lraton/FlopperZiro/docs/README.md

# FlopperZiro

> ⚠️ **This is a fun, open-source DIY project** — not a professional device. It is a work in progress and the hardware, PCB, and software may change across updates.

FlopperZiro is a cheap, DIY, fully open-source multi-tool inspired by the Flipper Zero. It is built around the **STM32-L432KC** microcontroller and programmed via **Arduino IDE**. It packs RF, IR, RFID/NFC, BadUSB, and SD card support into a single hand-held device you can build yourself.

---

## Features at a glance

| Feature | Status |
|---|---|
| 🦆 BadUSB / RubberDucky | ✅ Working |
| 📡 RF 433 MHz — scan, save, replay | ✅ Working |
| 🔴 IR — scan, save, replay | ✅ Working |
| 🔖 RFID/NFC — read, save, emulate | ✅ Working |
| 💾 SD card — save & load all signals | ✅ Working |
| 🔋 Battery percentage indicator | ✅ Working |
| 📊 SD free-space indicator | ✅ Working |
| 🖥️ OLED 128×64 display | ✅ Working |

---

## Navigation

Use the sidebar to explore the documentation:

- **[Setup](setup.md)** — Hardware assembly, libraries, and flashing
- **[Usage](usage.md)** — Button map and how to use each module
- **[Modules](modules.md)** — Deep-dive into every feature
- **[SD Card File Format](sd-format.md)** — How files are stored on the SD card
- **[Development](development.md)** — Code architecture, contributing, and roadmap
