lraton/FlopperZiro/(threads)

Thread 3 (2024-09-18):

Does it support 125kHz rfid?

Kitki30, 2024-09-18:

Kitki30, 2024-09-18:
i want to make my own flopper project (maybe it will be even worse) but i dont see any cheap 125 kHz rfid module in poland

Kitki30, 2024-09-18:
Also does it support emulating rfid?

lraton, 2024-09-18:
There is several board for reading 125khz tags, the pn532 can't. The emulation is a work in progress because i have some problem with it

Thread 4 (2024-10-26):

Case

LuciferBringerOfLight, 2024-10-26:
are there plans for a casing of any sort to house the pcb?

lraton, 2024-10-27:
I had created a draft, but I never published it, when I have time to fix it I think I'll publish it

Thread 5 (2024-10-27):

Using ras pi 0 w

IDknoobcoder, 2024-10-27:
Bro is there any way we could do this ras pi 0w

IDknoobcoder, 2024-10-28:
Also there is any chance that u could create a yt video explaining all the things and if there is a cheap substitute of the microcontroller u using

IDknoobcoder, 2024-10-28:
Showcase all functions

IDknoobcoder, 2024-10-28:
If u r using same board as flipper zero can’t u flash that firmware

lraton, 2024-10-28:
- I don't know if is possibile make a verison for  raspi 0 probably yes, but i'm not sure.
- You are not the first to ask me a video for explain everything, but for now i'll not make it, probably when i finish it.
- No u can't upload the flipper firmware

IDknoobcoder, 2024-10-29:
Ok
The pcb files aren’t loading in the website which I’m ordering
And which file to chose as there are 2pcb files
Also this RXB12 module is not available where I live so could I use rxb22

lraton, 2024-10-30:
The file for print the PCB is the gerber zip, and yes you can use the rxb22

Closed 2024-10-31.

Thread 6 (2024-11-03):

Use of another type of board

IDknoobcoder, 2024-11-03:
Bro could I use https://robu.in/product/gd32f103c8t6-minimum-system-board-microcomputer-stm32-arm-core-board/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 this board could u review it this is based on stm32 only . I have budget issues so I am asking

IDknoobcoder, 2024-11-04:
grazie per il tuo supporto per curiosità puoi fare la pizza, per favore, non preoccuparti

Closed 2024-11-04.

Thread 9 (2025-01-27):

The Website

iratonfan, 2025-01-27:
The website you provided is not working i  just wanna know how do i flash the firmware and also i'm building this project and you are saying there are some things that are not available right now can u tell me clearly what are those so that i can work on those

iratonfan, 2025-01-27:
and what are the problems that are caused by the PN532 and if you have any idea on whats causing it

iratonfan, 2025-01-28:
and i want to also ask about the usb smd why is it there and where do the d+ and d- pins go?

iratonfan, 2025-01-29:
and it also has an issue where both the SCREEN and the FS1000A both are connected to PA7

lraton, 2025-01-29:
Yes not everything is working, like the nfc reading and emulation, i need to change the pn for working with the emulation cause it change the first byte when you try to emulate and uid, and is inside the hardware so i can't handle with this.
I need to finish some function for saving in the sd card
The smd usb is there because i connected to the pa11 and pa12 pin on the board, for make the hid connection.
Yes, the PA7 pin is a typo error, the screen is connected on the PB6 and PB7 (not pa7)

iratonfan, 2025-01-30:
ok thanks a lot ur the best i named myself after u

Closed 2025-01-30.

Thread 10 (2025-01-31):

Multiple pins leading to the same

iratonfan, 2025-01-31:
The PA7 pin on the screen is also connected to the FS1000A
Then u said to connect it the screen to PB6,PB7 but the PN532 module is already connected to those
More over,
The PA0 is connected to the SD module as well as the SOTTO button
Also u haven't specified me in the last issue where do the D+ and D- pin on the USB smd go?

lraton, 2025-01-31:
Yes, the screen and the pn are connected on the same pin because they use i2c protocol.
Yes the pa0 are used on the sd and on the button, but it doesn't make problem.
The smd usb go on pa11(d-) and pa12(d+).

If you upload the gerber file on a circuit design program, you can see everything

iratonfan, 2025-02-01:
thanks that helps a lot

Closed 2025-01-31.

Thread 11 (2025-02-02):

How to copy the firmware

iratonfan, 2025-02-02:
well you helped me out a lot and i have created a device as u mentioned i'm having a problem setting the firmware i installed the arduino ide connected the Microcontroller usb to my pc and using git bash to clone the repo but it keeps sending me an error that there is no more space i've also connected a micro SD card to the module but there is no success please solve my issue

Thread 12 (2025-05-10):

Bruce

Magmucot, 2025-05-10:
You know what Bruce is, I have a suggestion, you can transfer the flopper to it, although you will have to replace the display with a tft, you will also need to add the cc1101 module.

lraton, 2025-07-10:
Interesting, maybe one day I'll try to put it up

Magmucot, 2025-07-28:
I can help u, I have schematic
