lraton/FlopperZiro/PCB and Schematic/PCB/PCB_PCB_FlopperZiro_2024.pdf

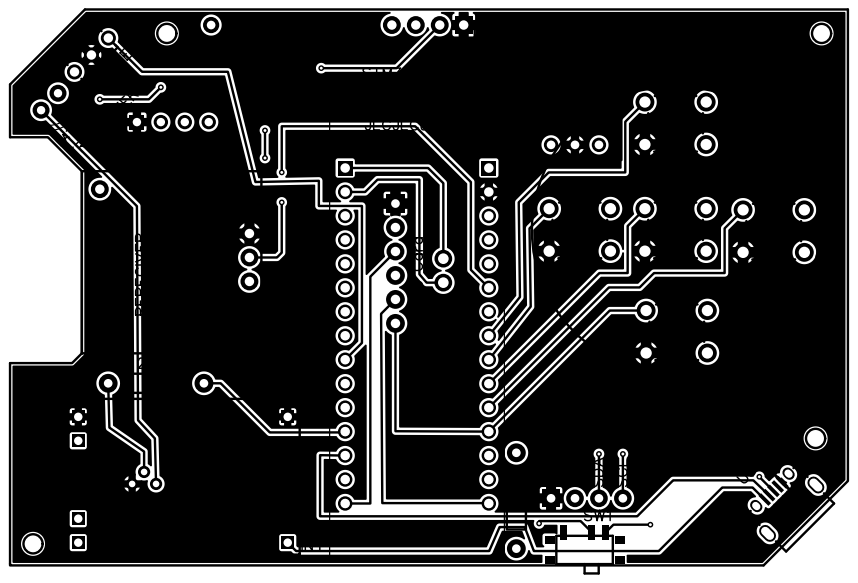
[picture p5: page 1]
