lraton/FlopperZiro/PCB and Schematic/Schematic/Schematic_FlopperZiro_2024.pdf

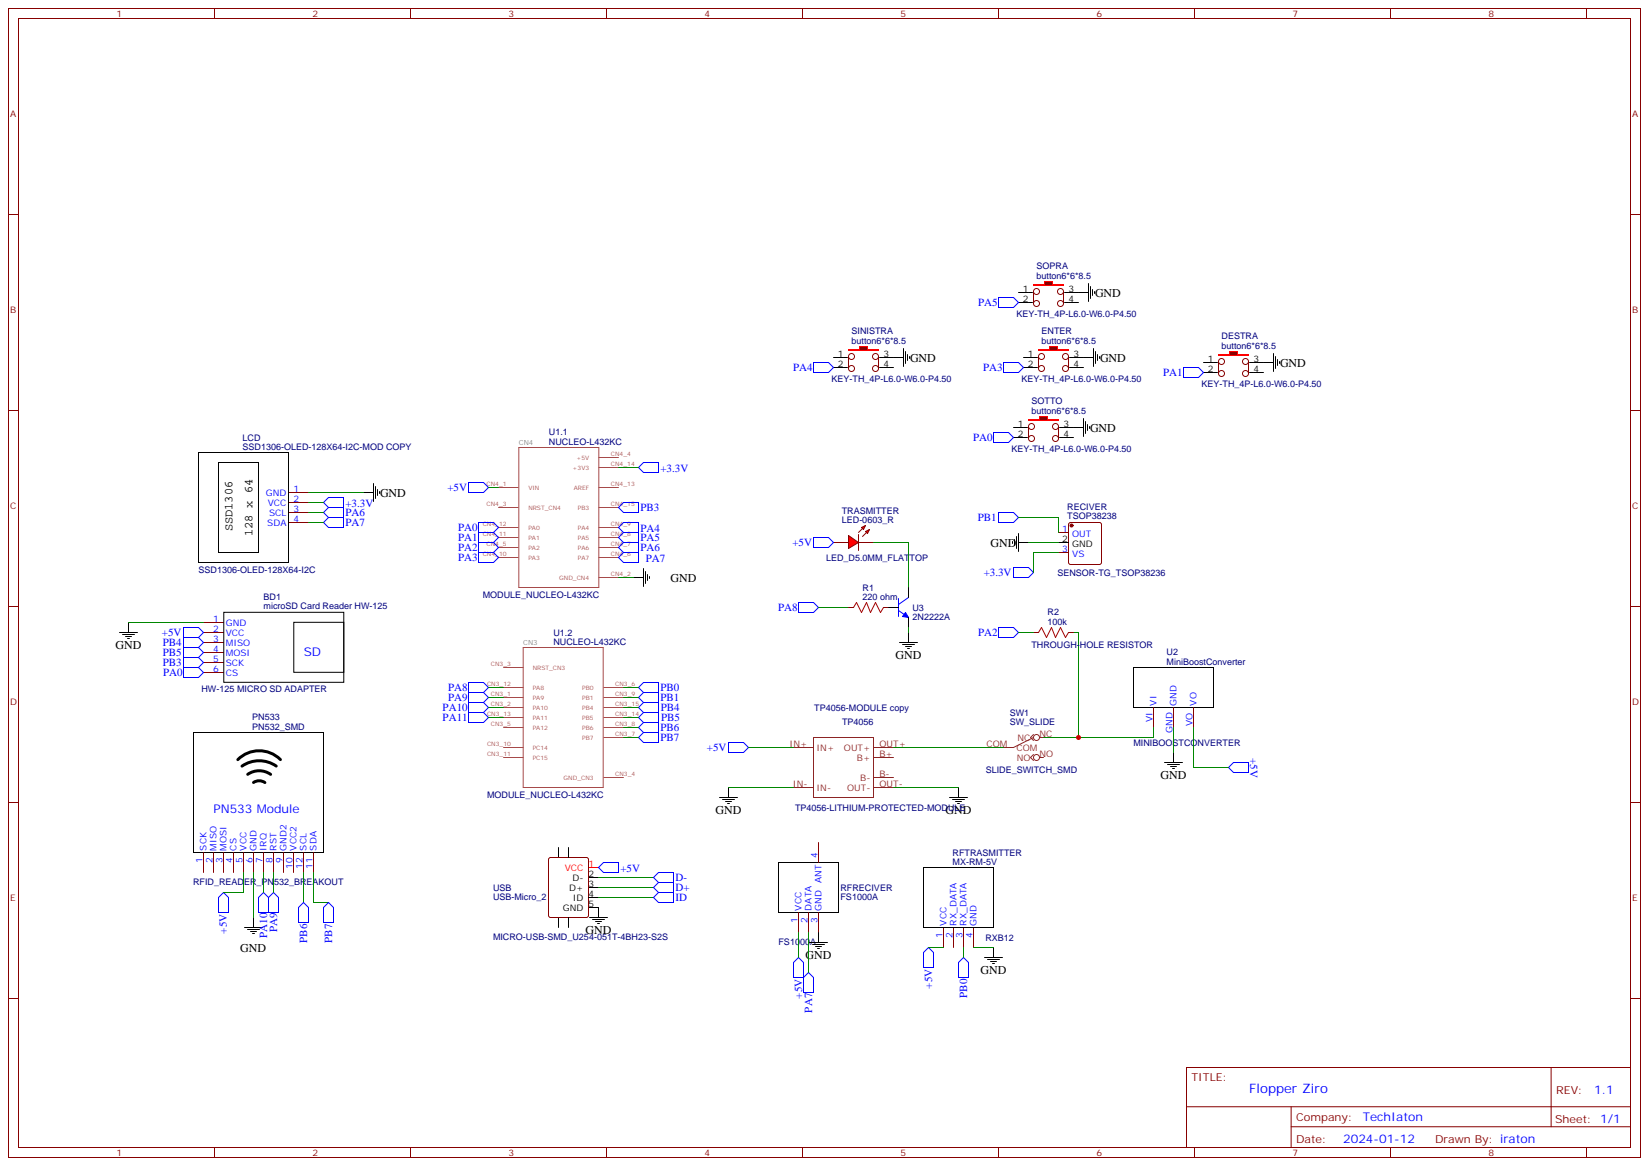
[picture p6: page 1]

microSD Card Reader HW-125
