lraton/FlopperZiro/PCB and Schematic/PCB/PCB_PCB_FlopperZiro_2024-01-12.pdf

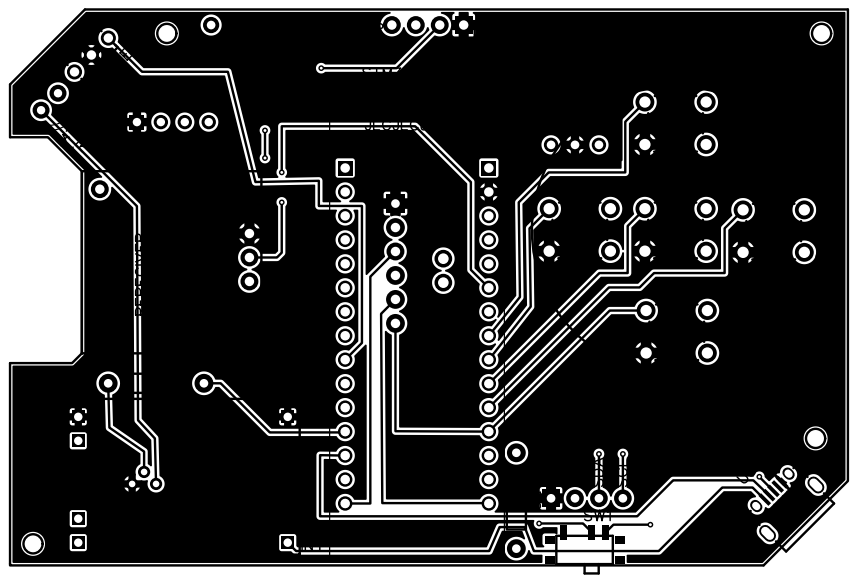
[picture p7: page 1]
