lraton/FlopperZiro/PCB and Schematic/Schematic/Schematic_FlopperZiro_2024-01-12.pdf

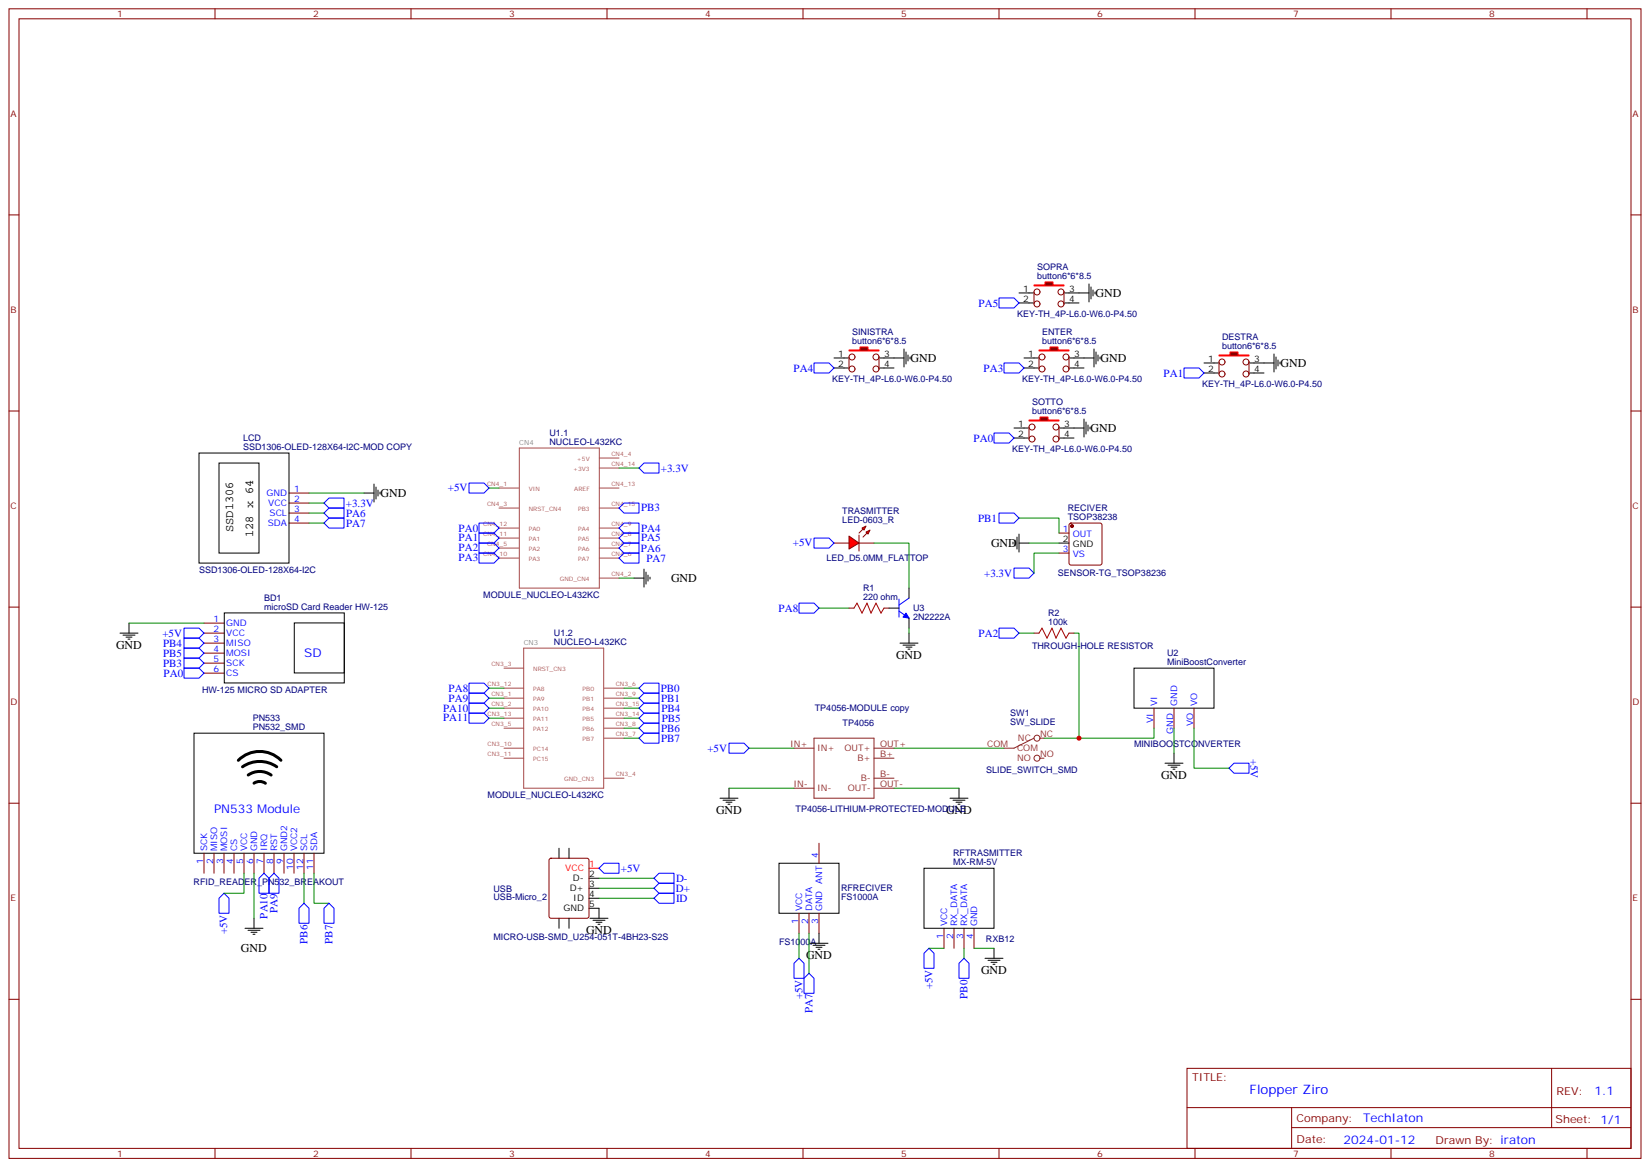
[picture p8: page 1]

microSD Card Reader HW-125
