lraton/FlopperZiro/PCB and Schematic/PCB/PCB_PCB_FlopperZiro_2023-01-23.pdf

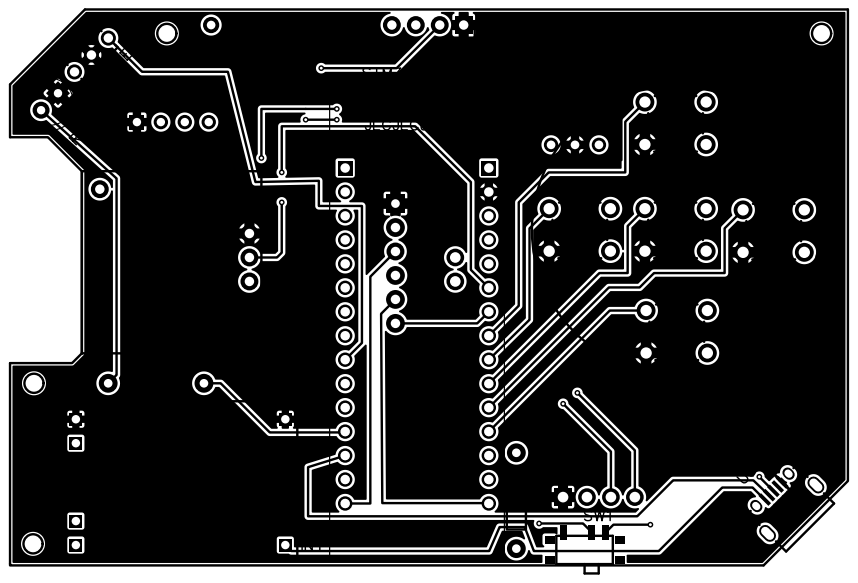
[picture p9: page 1]
