lraton/FlopperZiro/PCB and Schematic/Schematic/Schematic_FlopperZiro_2023-01-23.pdf

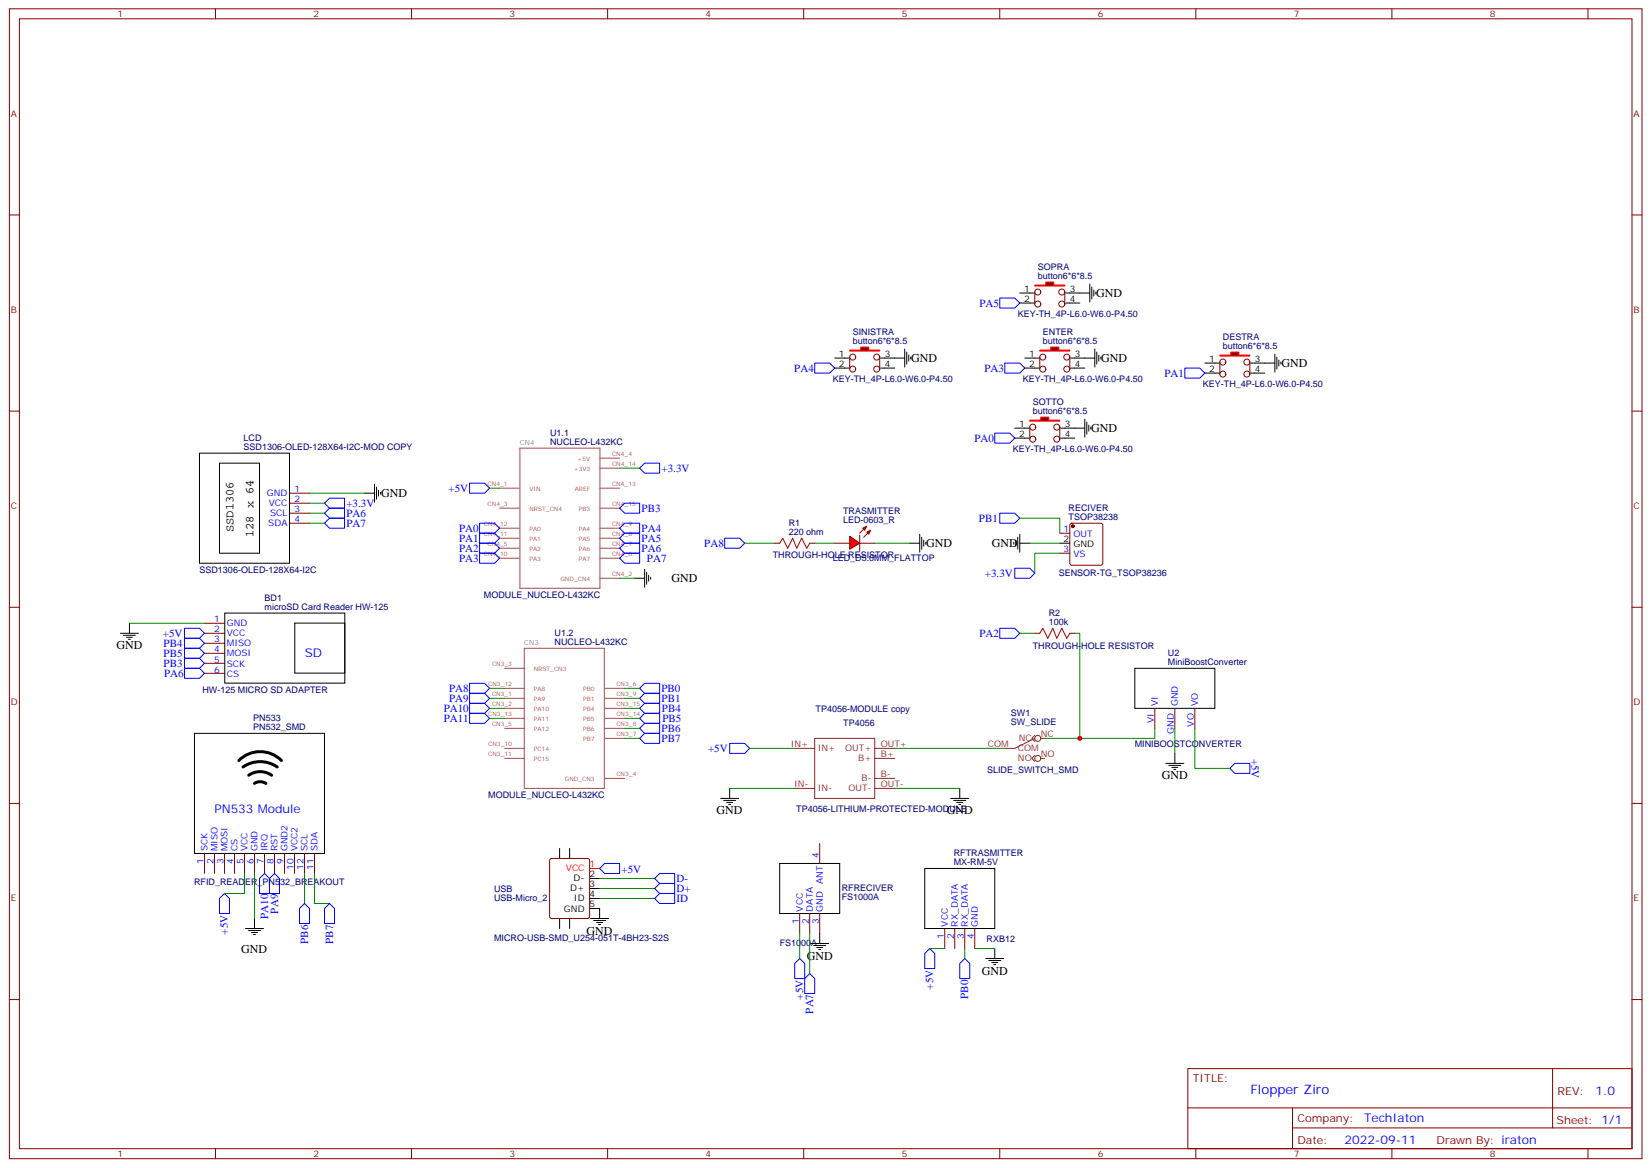
[picture p10: page 1]

microSD Card Reader HW-125
