lraton/FlopperZiro/(list of files, drawings)

Other design files:
PCB and Schematic/PCB/PCB_PCB_FlopperZiro_2024.json
PCB and Schematic/Schematic/SCH_FlopperZiro_2024.json
