lraton/FlopperZiro/main/graphics.ino

/*
 * Copyright (c) 2024, lraton 
 * All rights reserved.
 *
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
 * You should have received a copy of the GNU General Public License
 * along with this program. If not, see <https://www.gnu.org/licenses/>.
 */

//all the function to display the graphics
const unsigned char flopper[] PROGMEM = {
  0xff, 0xff, 0xff, 0xff, 0xff, 0xff, 0xff, 0xff, 0xff, 0xff, 0xff, 0xff, 0xff, 0xff, 0xff, 0xff,
  0x80, 0x00, 0x00, 0x00, 0x00, 0x00, 0x00, 0x00, 0x00, 0x00, 0x00, 0x00, 0x00, 0x00, 0x00, 0x01,
  0x80, 0x00, 0x00, 0x00, 0x00, 0x00, 0x00, 0x00, 0x00, 0x00, 0x00, 0x00, 0x00, 0x00, 0x00, 0x01,
  0x80, 0x00, 0x00, 0x00, 0x00, 0x00, 0x00, 0x00, 0x00, 0x00, 0x00, 0x00, 0x00, 0x00, 0x00, 0x01,
  0x80, 0x00, 0x00, 0x00, 0x00, 0x00, 0x00, 0x00, 0x00, 0x00, 0x00, 0x00, 0x00, 0x00, 0x00, 0x01,
  0x80, 0x00, 0x00, 0x00, 0x00, 0x00, 0x00, 0x00, 0x00, 0x00, 0x00, 0x00, 0x00, 0x00, 0x00, 0x01,
  0x80, 0x00, 0x00, 0x00, 0x00, 0x00, 0x00, 0x00, 0x00, 0x00, 0x00, 0x00, 0x00, 0x00, 0x00, 0x01,
  0x80, 0x00, 0x00, 0x00, 0x00, 0x00, 0x00, 0x00, 0x00, 0x00, 0x00, 0x00, 0x00, 0x00, 0x00, 0x01,
  0x83, 0xff, 0xf3, 0x80, 0x00, 0x00, 0x00, 0x00, 0x00, 0x00, 0x00, 0x00, 0x00, 0x00, 0x00, 0x01,
  0x83, 0xff, 0xf3, 0x80, 0x00, 0x00, 0x00, 0x00, 0x00, 0x00, 0x00, 0x00, 0x00, 0x00, 0x00, 0x01,
  0x83, 0xff, 0xf3, 0x80, 0x00, 0x00, 0x00, 0x00, 0x00, 0x00, 0x00, 0x00, 0x00, 0x00, 0x00, 0x01,
  0x83, 0xc0, 0x03, 0x80, 0x00, 0x00, 0x00, 0x00, 0x00, 0x00, 0x00, 0x00, 0x00, 0x00, 0x00, 0x01,
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
void drawHomeScreen() {
  display.clearDisplay();
  display.drawBitmap(0, 0, flopper, 128, 64, WHITE);
  displayBattery();
}

// Draws the BadUSB module menu page.
void drawUsbMenuPage() {
  display.clearDisplay();
  display.drawBitmap(0, 0, immagineusb, 128, 64, WHITE);
  displayBattery();
}

// Draws the RFID module menu page.
void drawRfidMenuPage() {
  display.clearDisplay();
  display.drawBitmap(0, 0, immaginerfid, 128, 64, WHITE);
  displayBattery();
}

// Draws the IR module menu page.
void drawIrMenuPage() {
  display.clearDisplay();
  display.drawBitmap(0, 0, immagineir, 128, 64, WHITE);
  displayBattery();
}

// Draws the RF module menu page.
void drawRfMenuPage() {
  display.clearDisplay();
  display.drawBitmap(0, 0, immaginerf, 128, 64, WHITE);
  displayBattery();
}

// Draws the SD card icon bitmap at (x, y).
void drawSdIcon(int x, int y) {
  display.drawBitmap(x, y, sd_bitmap, 12, 8, WHITE);
}

// Draws the battery icon bitmap at (x, y).
void drawBatteryIcon(int x, int y) {
  display.drawBitmap(x, y, battery_bitmap, 8, 8, WHITE);
}

// ─── Module-specific screen drawing functions ─────────────────────────────────

// Draws the BadUSB active screen (reuses the standard scan base frame).
void drawUsbScreen() {
  drawScanBase();
}

// Draws the sub-menu selection screen and handles sub-menu button input.
void drawSubMenu() {
  display.clearDisplay();
  display.drawBitmap(0, 0, frame, 128, 64, WHITE);
  int textY = 17;
  display.setCursor(10, textY);

  // Default to page 1 if the user lands on the placeholder page 0.
  if (subMenuCurrentPage == 0) subMenuCurrentPage = 1;

  switch (subMenuCurrentPage) {
    case 1:
      display.println("> Scan Signal");
      display.setCursor(10, textY += 10);
      display.println("  Emulate from SD");
      break;
    case 2:
      display.println("  Scan Signal");
      display.setCursor(10, textY += 10);
      display.println("> Emulate from SD");
      break;
  }

  displayBattery();
  handleSubMenuButtons();
}

// Draws the base scan frame (border + button hints at the bottom).
void drawScanBase() {
  display.clearDisplay();
  display.drawBitmap(0, 0, scan, 128, 64, WHITE);
  display.setCursor(55, 5);  display.println("scan");
  display.setCursor(13, 52); display.println("back");
  display.setCursor(55, 52); display.println("save");
  display.setCursor(95, 52); display.println("emul.");
}

// Draws the scan base frame with "Scanning..." in the centre.
void drawScanScreen() {
  drawScanBase();
  display.setCursor(33, 30);
  display.println("Scanning...");
}
