lraton/FlopperZiro/(commit log)

2023-01-17 Made first prototype menu
2023-01-17 Fixed graphics and delay
    [badusb.ino, buttonMenu.ino, graphics.ino, main.ino, menu.ino, rfid.ino]
2023-01-19 Added battery percentage
2023-01-21 Adde rf variable and change battery pin
2023-01-23 Added the pcb file and schematic
    [PCB_PCB_FlopperZiro_2023-01-23.json, SCH_FlopperZiro_2023-01-23.json]
2023-01-23 Fix calibration battery
2023-04-07 Added right button, recive ir and emulate
2023-04-10 removed usless button page
2023-04-30 Fixed rf sending and badusb
    [badusb.ino, buttonMenu.ino, main.ino, rf.ino]
2023-05-02 removed serial print and fix badusb button
    [battery.ino, buttonMenu.ino]
2023-08-30 Fixed the Ir file read and some graphics
    [buttonMenu.ino, graphics.ino, ir.ino, sdList.ino]
2023-08-31 Fixed ir and rf saving method
    [badusb.ino, buttonMenu.ino, graphics.ino, ir.ino, rf.ino, sdList.ino]
2024-01-12 New version of PCB, with right connection and added transistor
    [PCB_PCB_FlopperZiro_2023-01-23.json, PCB_PCB_FlopperZiro_2024-01-12.json, SCH_FlopperZiro_2023-01-23.json, SCH_FlopperZiro_2024-01-12.json]
2024-10-30 update PCB
    [PCB_PCB_FlopperZiro_2024-01-12.json, PCB_PCB_FlopperZiro_2024.json, SCH_FlopperZiro_2024-01-12.json, SCH_FlopperZiro_2024.json]
2025-07-14 Add 3d printed shell
2025-07-14 fix ir conflict with rf
    [main.ino]
2025-07-14 fix device locking
2025-07-14 fix rfid non-blocking reading
    [main.ino, rfid.ino]
2025-07-14 fix rfid read
    after read a card he doesn't read nothing anymore, fixed
    [buttonMenu.ino, main.ino, rfid.ino]
2025-07-14 add print on file exist
2025-07-14 add sd memory left percentage
    refresh only when power on and after a save
2025-07-14 update homepage rfid error and image
    [graphics.ino, main.ino, menu.ino]
2026-05-31 Revamp docs: add modules & SD format
    Overhaul project documentation: rewrite README with a clear features summary and navigation; update sidebar links and repo URL; expand Development with code architecture, file map, global state, roadmap, libraries, and contributor instructions; greatly expand Setup with hardware list, pin map, Arduino/board/library install steps, SD card prep, and flashing notes; expand Usage with button/layout, menus, module workflows, and lock mode. Add new technical references: docs/modules.md (per-module details for BadUSB, RFID, IR, RF, Battery, SD) and docs/sd-format.md (precise on-disk file formats). Small editorial fixes and improved links throughout.
2026-05-31 feat (ai slop): Add RFID emulation and fix SD save/load
    Implement RFID emulation using PN532 tgInitAsTarget (supports 4- and 7-byte UIDs), with display UI and a 3s blocking timeout. Fix saveRfid(): correct file-exists check, document file layout, and write UID bytes one-per-line without accidental string arithmetic. Implement SD load in sdList selectedSd case 2 to parse cardType, uidLength (clamped) and UID bytes back into RAM and update UI state. Miscellaneous comment and formatting improvements.
    [rfid.ino, sdList.ino]
2026-05-31 Refactor naming and UI/button logic
    Renamed and refactored many functions/variables across modules for clarity and consistency (camelCase names like badUsb, executeBadUsb, executeScriptLine, pressKey, displayBattery, drawSdIcon, mapFloat, handleMenuButtons, handleModuleButtons, handleSdButtons, etc.).
    Changes unify SD/battery UI rendering and layout, improve BadUSB script parsing/execution (DuckyScript handling moved to executeScriptLine/pressKey), and reorganize menu/submenu/SD navigation and button handlers. IR handling was cleaned up (scanIr, printIrInfo, printIrCode, getIrProtocolName) and serial output formatting improved. Minor API renames for SD and file helpers (countFiles, drawSdFi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
2026-05-31 Docs: rename variables/functions and clarify NFC
    Rename many variables and helper function names across docs for clarity and to match recent code refactors (development.md, modules.md, sd-format.md, usage.md, _sidebar.md). Changes include more descriptive identifiers (e.g. scelta → selectedModule, uid[] → rfidUid[], rawData → irRawData, mySwitch → rfSwitch, tag → deviceUnlocked), updated function names for UI/SD/button handling (e.g. displayBattery, handleModuleButtons, drawSdFileList, loadSelectedFile), and updated SD file field names. Clarifies PN532 emulation: doc now explains building and sending the raw TgInitAsTarget command, draining response via Wire.requestFrom(), and call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
2026-06-01 Add PN532 emulation and NTAG memory handling
    Implement low-level PN532 I2C frame helpers and full card-emulation flow (TgInitAsTarget, TgGetData, TgSetData) so the device can emulate ISO14443A/NTAG and respond to basic APDUs. Add a 256-byte ntagData buffer and rfidCardType string, zero-pad UID hex output, and reset RFID buffers when starting a new scan. NTAG pages are dumped into ntagData during scanning, saved to the SD card for 7-byte UIDs, and restored when loading files. Also add user-abort and timeout handling for PN532 operations and improve display/messages during emulation.
    [buttonMenu.ino, main.ino, rfid.ino, sdList.ino]
2026-06-01 Add troubleshooting and clarifying notes to README
    Update README.md to include a brief note describing the project as a DIY Flipper Zero clone and to add a Troubleshooting section. The new troubleshooting entry documents a known blank-screen timing quirk after Arduino IDE uploads and provides a simple workaround: open the Arduino Serial Monitor/Debugger to trigger a software reset so the device boots normally.
2026-06-17 feat: add logo and update docs metadata
    Add site logo and favicon images, embed the logo in README, and enhance docs/index.html with improved title, description, keywords, Open Graph and Twitter meta tags, and favicon/apple-touch links. Also enable the docsify logo setting and correct the IR receiver pin note in docs/setup.md (`D6` shown as `6` in code).
2026-06-17 fix> switch logo and favicon from JPG to PNG
    Replace JPG logo and favicon with PNG files and update references.
    - Added img/logo.png and docs/favicon.png.
    - Removed docs/favicon.jpg.
    - Updated README.md to reference img/logo.png.
    - Updated docs/index.html meta tags (og/twitter image), favicon links, and docsify logo to use favicon.png.
